rrainey/DSKY_EL_replica/PCB - KiCad/DSKY_driver_clr/Driver.Segment.PCB.BOM.xlsx

DRIVER BOARD
Verified | Designator | MFR P/N | Description | QTY | Mouser | Price | EXT | Digikey | Price | EXT
V | U1, U5, U7 | HV507PG-G | Serial to Parallel Logic Converters 325V 64Ch Push-Pull | 3 | 689-HV507PG-G | $14.34 | $43.02 | HV507PG-G-ND | $14.35 | $43.05
 | IC3 | ATSAMD21E18A-MUT | ARM Microcontrollers - MCU 256KB 32QFN GRN 1.6-3.6V 48MHz | 1 | 556-ATSAMD21E18A-MUT | $3.00 | $3.00 | ATSAMD21E18A-MUTCT-ND | $3.01 | $3.01
V | IC3 |  | ATSAMD21E18 Trinket M0 SAM D ARM® Cortex®-M0+ MCU 32-Bit Embedded Evaluation Board | 1 | 485-3500 | $8.95 | $8.95 | 1528-2361-ND | $8.95 | $8.95
V | TR1, TR2 | ATB322524-0110 | Audio Transformers / Signal Transformers Photoflash Capacitor Charging Transformer | 2 | 810-ATB322524-0110 | $1.78 | $3.56 | 445-8636-1-ND | $1.98 | $3.96
V | U2, U6 | LT3468ES5#TRMPBF | Switching Voltage Regulators 500mA Photoflash Capacitor Charger | 2 | 584-LT3468ES5#TRMPBF | $5.06 | $10.12 | LT3468ES5#TRMPBFCT-ND | $5.07 | $10.14
V | D1, D2 | B0540W-7-F | Schottky Diodes & Rectifiers 40V 410mW | 2 | 621-B0540W-F | $0.39 | $0.78 | B0540W-FDICT-ND | $0.30 | $0.60
V | D3, D4 | MMBD5004S-7 | Diodes - General Purpose, Power, Switching 350MW 400V | 2 | 621-MMBD5004S-7 | $0.43 | $0.86 | MMBD5004S-7DICT-ND | $0.43 | $0.86
V | U8 | CD40109BPWR | Translation - Voltage Levels Quad L-H Voltage | 1 | 595-CD40109BPWR | $0.42 | $0.42 | 296-12163-1-ND | $0.43 | $0.43
V | U4 | AP2204K-5.0TRG1 | LDO Voltage Regulators 150mA CMOS LDO 5.0V | 1 | 621-AP2204K-5.0TRG1 | $0.44 | $0.44 | AP2204K-5.0TRG1DICT-ND | $0.45 | $0.45
V | U3 | AP2204K-3.3TRG1 | LDO Voltage Regulators 200mA CMOS LDO 3.3V | 1 | 621-AP2204K-3.3TRG1 | $0.44 | $0.44 | AP2204K-3.3TRG1DICT-ND | $0.45 | $0.45
 | R1 | RC0603FR-071K5L | Thick Film Resistors - SMD 1.5K OHM 1% | 1 | 603-RC0603FR-071K5L | $0.10 | $0.10 | 311-1.50KHRCT-ND | $0.10 | $0.10
 | R4 | RC0603FR-0710KL | Thick Film Resistors - SMD 10K OHM 1% | 1 | 603-RC0603FR-0710KL | $0.10 | $0.10 | 311-10.0KHRCT-ND | $0.10 | $0.10
 | R3 | RC0603FR-07100KL | Thick Film Resistors - SMD 100K OHM 1% | 1 | 603-RC0603FR-07100KL | $0.10 | $0.10 | 311-100KHRCT-ND | $0.10 | $0.10
 | R2 | RC0603FR-0710ML | Thick Film Resistors - SMD 10M OHM 1% | 1 | 603-RC0603FR-0710ML | $0.10 | $0.10 | 311-10.0MHRCT-ND | $0.10 | $0.10
V | C5, C9 | C1608X5R1C685K080AB | Multilayer Ceramic Capacitors MLCC - SMD/SMT 0603 16V 6.8uF X5R 10% T: 0.8mm | 2 | 810-C1608JB1A685K08C | $0.62 | $1.24 | 445-14139-1-ND | $0.72 | $1.44
V | C15, C16, C17 | C3225X7T2W224K200AA | Multilayer Ceramic Capacitors MLCC - SMD/SMT 1210 450V 0.22uF X7T 10% T: 2mm | 3 | 810-C1608X5R1C685K0B | $0.95 | $2.85 | 445-7765-1-ND | $0.73 | $2.19
V | C4 | C5750X6S2W225K250KA | Multilayer Ceramic Capacitors MLCC - SMD/SMT 2220 450V 2.2uF X6S 10% T: 2.5mm | 1 | 810-C5750X6S2W225KKA | $0.32 | $0.32 | 445-7781-1-ND | $3.99 | $3.99
 | C10 | C0603C103K9RACTU | Multilayer Ceramic Capacitors MLCC - SMD/SMT 6.3V 0.01uF 0603 X7R 10% | 1 | 80-C0603C103K9R | $0.11 | $0.11 | 399-8988-1-ND | $0.11 | $0.11
 | C14,C13,C12,C11,C2,C3 | C0603C105K8RACTU | Multilayer Ceramic Capacitors MLCC - SMD/SMT 10volts 1uF 10% X7R | 6 | 80-C0603C105K8R | $0.10 | $0.60 | 399-11133-1-ND | $0.10 | $0.60
 | C1,C7,C8 | 0805ZC106KAT4A | Multilayer Ceramic Capacitors MLCC - SMD/SMT 10V 10uF X7R 0805 0.1 | 3 | 581-0805ZC106KAT4A | $0.87 | $2.61 | 478-10578-1-ND | $0.80 | $2.40
 | C6 | 885012006008 | Multilayer Ceramic Capacitors MLCC - SMD/SMT 6.3V 100pF X7R 0603 5% | 1 | 710-885012006008 | $0.10 | $0.10 | 732-7752-1-ND | $0.10 | $0.10
 | Q2 | 1301.9317 | Tactile Switches SHORT TRAVEL SWITCH 6X6, 7.3MM | 1 | 693-1301.9317 | $0.24 | $0.24 | 486-3468-ND | $0.24 | $0.24
V | X1 | 105133-0011 | USB Connectors USB B Rec Vertical SMT 2.30 | 1 | 538-105133-0011 | $0.94 | $0.94 | WM10134CT-ND | $1.11 | $1.11
 | L1 | 150060RS75000 | Standard LEDs - SMD WL-SMCW SMDMono TpVw Waterclr 0603 Red | 1 | 710-150060RS75000 | $0.14 | $0.14 | 732-4978-1-ND | $0.14 | $0.14
 | PWR1 | 150060VS75000 | Standard LEDs - SMD WL-SMCW SMDMono TpVw Waterclr 0603 BrtGrn | 1 | 710-150060VS75000 | $0.14 | $0.14 | 732-4980-1-ND | $0.14 | $0.14
V | J3 | PJ-006B-SMT-TR | DC Power Connectors power jack, 2.5 x 5.5 mm, vertical, SMT, 1 switch, T&R package | 1 | 490-PJ-006B-SMT-TR | $1.04 | $1.04 | CP-006BPJCT-ND | $1.14 | $1.14
V | J1, J2, J4 | FX6-60S-0.8SV(71) | Board to Board & Mezzanine Connectors RCP 60 POS 0.8mm Solder ST SMD Stick | 3 | 798-FX6-60S-0.8SV71 | $3.53 | $10.59 | H10806-ND | $3.53 | $10.59
V | P1 | WSU090-2000-13 | 100-240V WALL PLUG-IN PWR SUPPLY | 1 | 553-WSU090-2000-13 | $11.45 | $11.45 | 237-2263-ND | $12.39 | $12.39
ARM Chip Only |  |  |  |  |  |  | #ERROR! |  |  | #ERROR!
ARM Chip on Development Board |  |  |  |  |  |  | #ERROR! |  |  | #ERROR!
SEGMENT BOARD
V | J1, J2, J3 | FX6-60P-0.8SV(71) | Board to Board & Mezzanine Connectors HDR 60 POS 0.8mm Solder ST SMD Stick | 3 | 798-FX6-60P-0.8SV71 | $3.68 | $11.04 | H10787-ND | $3.68 | $11.04
V | D1 | MMBD5004S-7 | Diodes - General Purpose, Power, Switching 350MW 400V | 1 | 621-MMBD5004S-7 | $0.43 | $0.43 | MMBD5004S-7DICT-ND | $0.43 | $0.43
 |  |  |  |  |  |  | $11.47 |  |  | $11.47
 | Requires desoldering to obtain the chip
 | No equivalent
