rrainey/DSKY_EL_replica/PCB - KiCad/DSKY_driver_clr/DSKY_driver.kicad_pcb

## KiCad design PCB - KiCad/DSKY_driver_clr/DSKY_driver.kicad_pcb (2021-01-31)

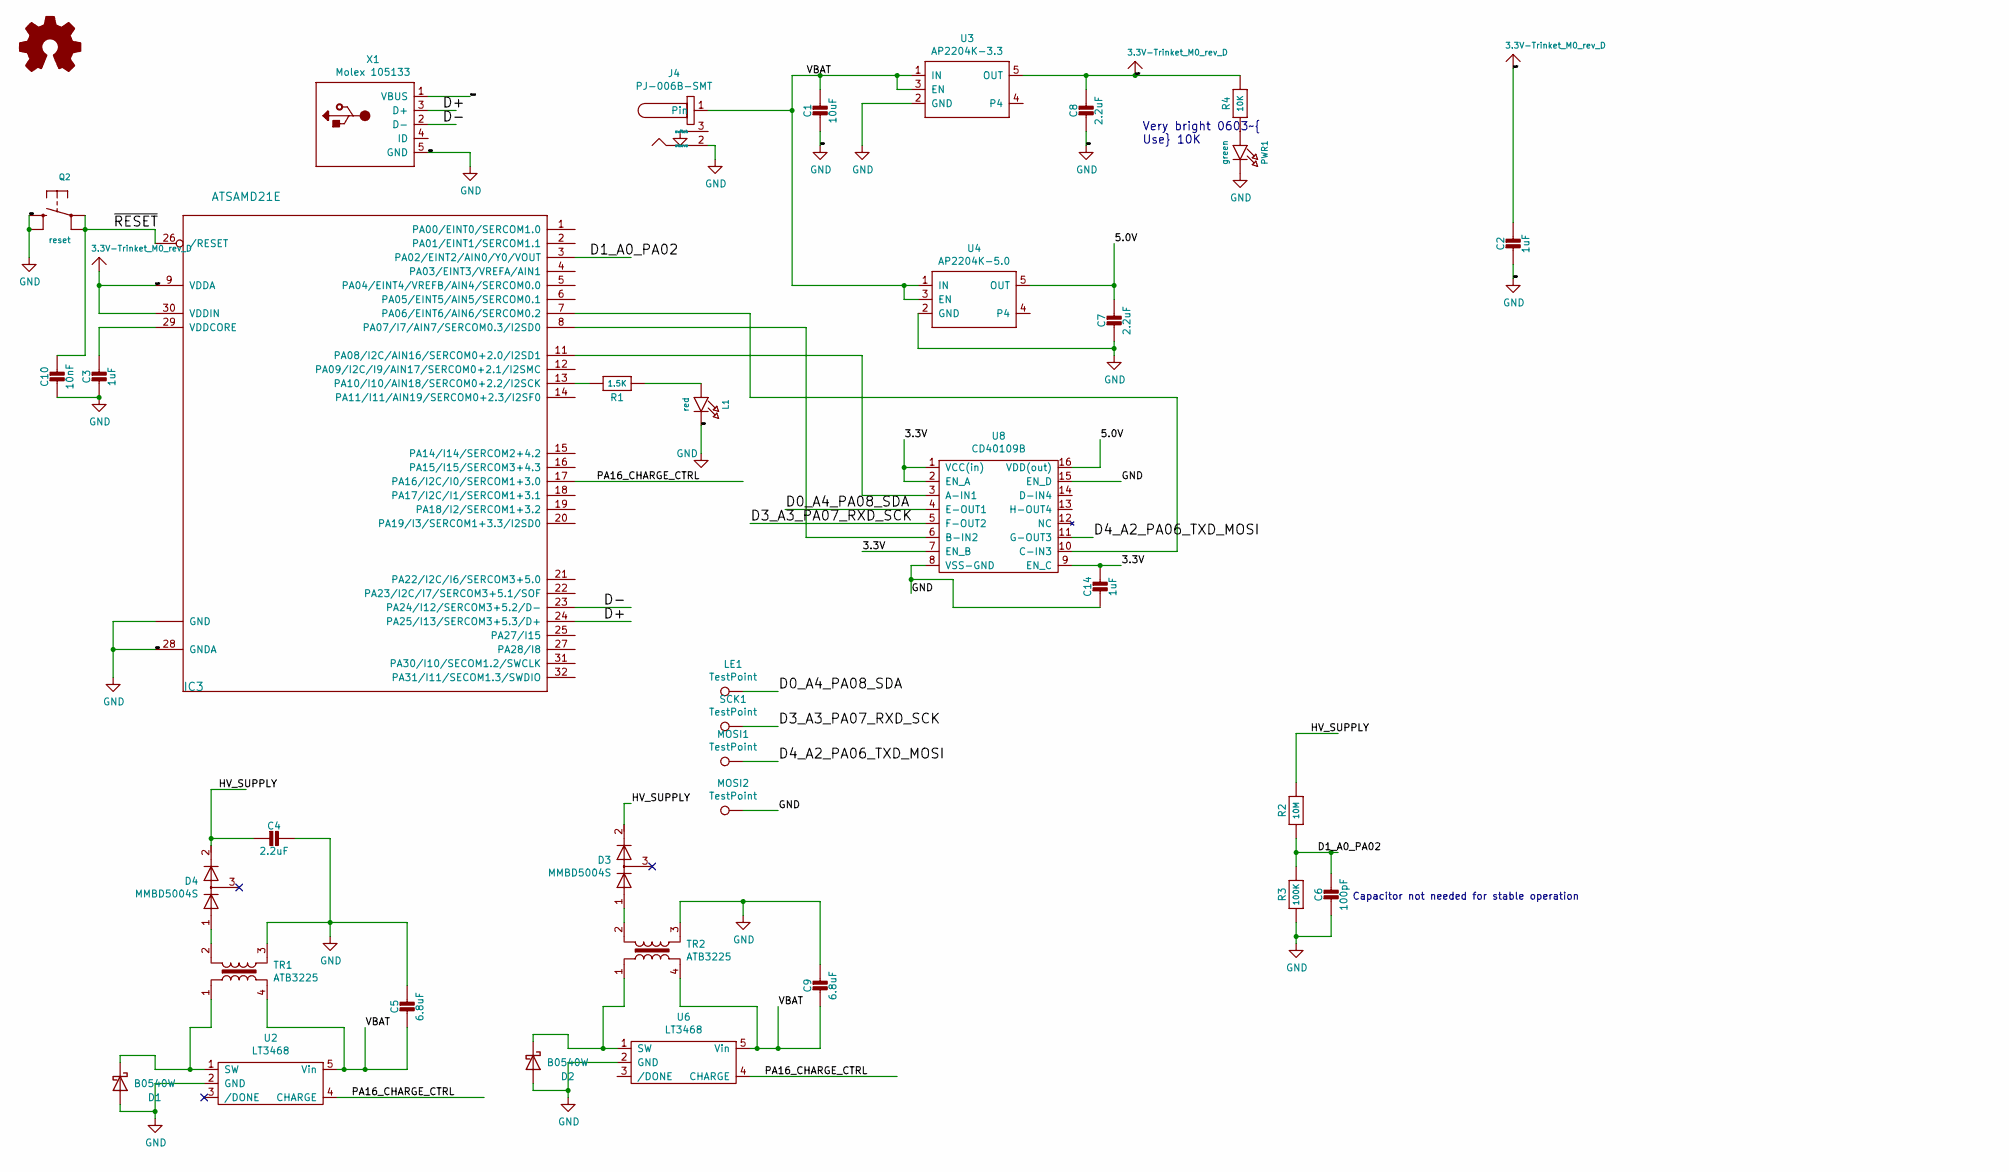
[picture p1: schematic DSKY_driver.sch, part in row 1, column 1]

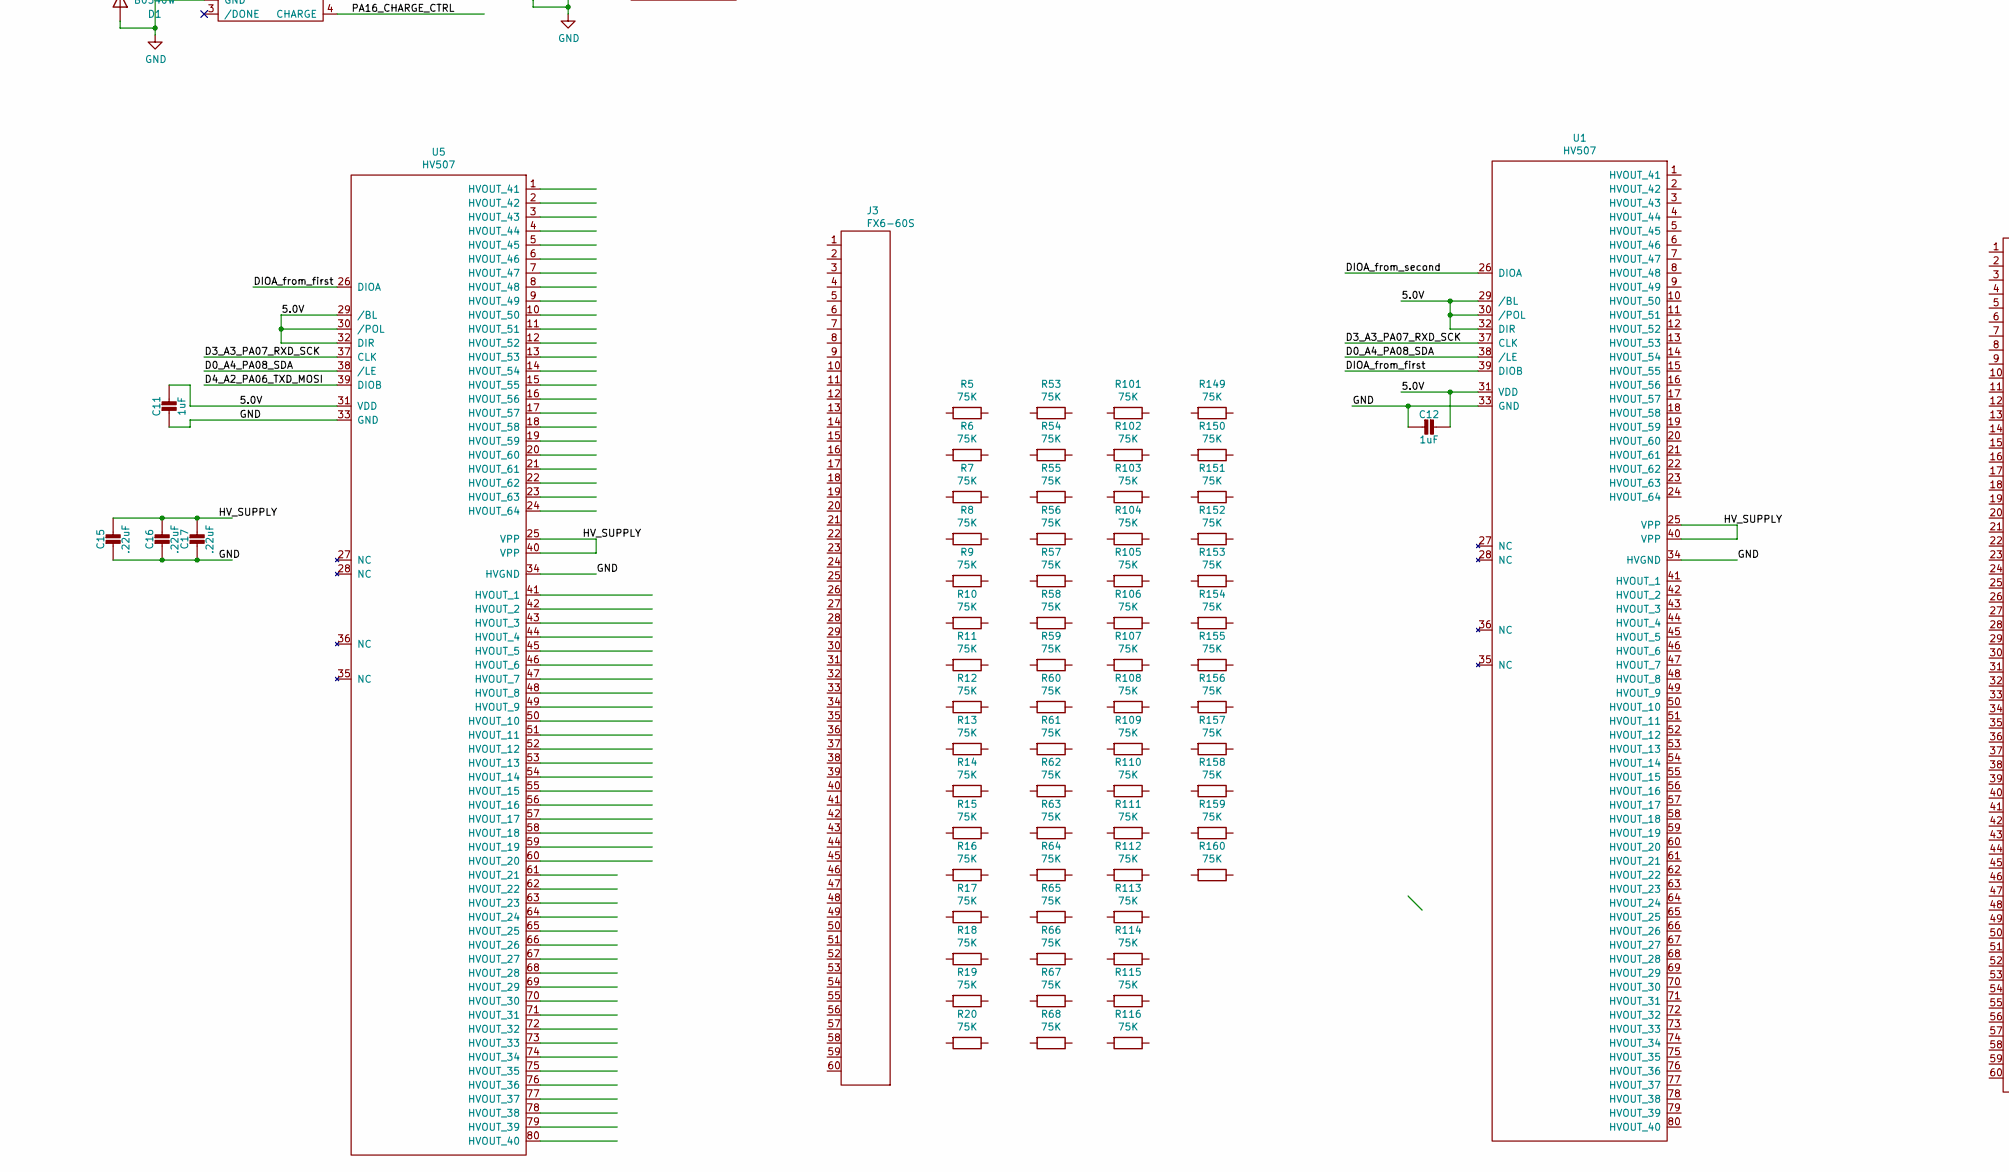
[picture p2: schematic DSKY_driver.sch, part in row 2, column 1]

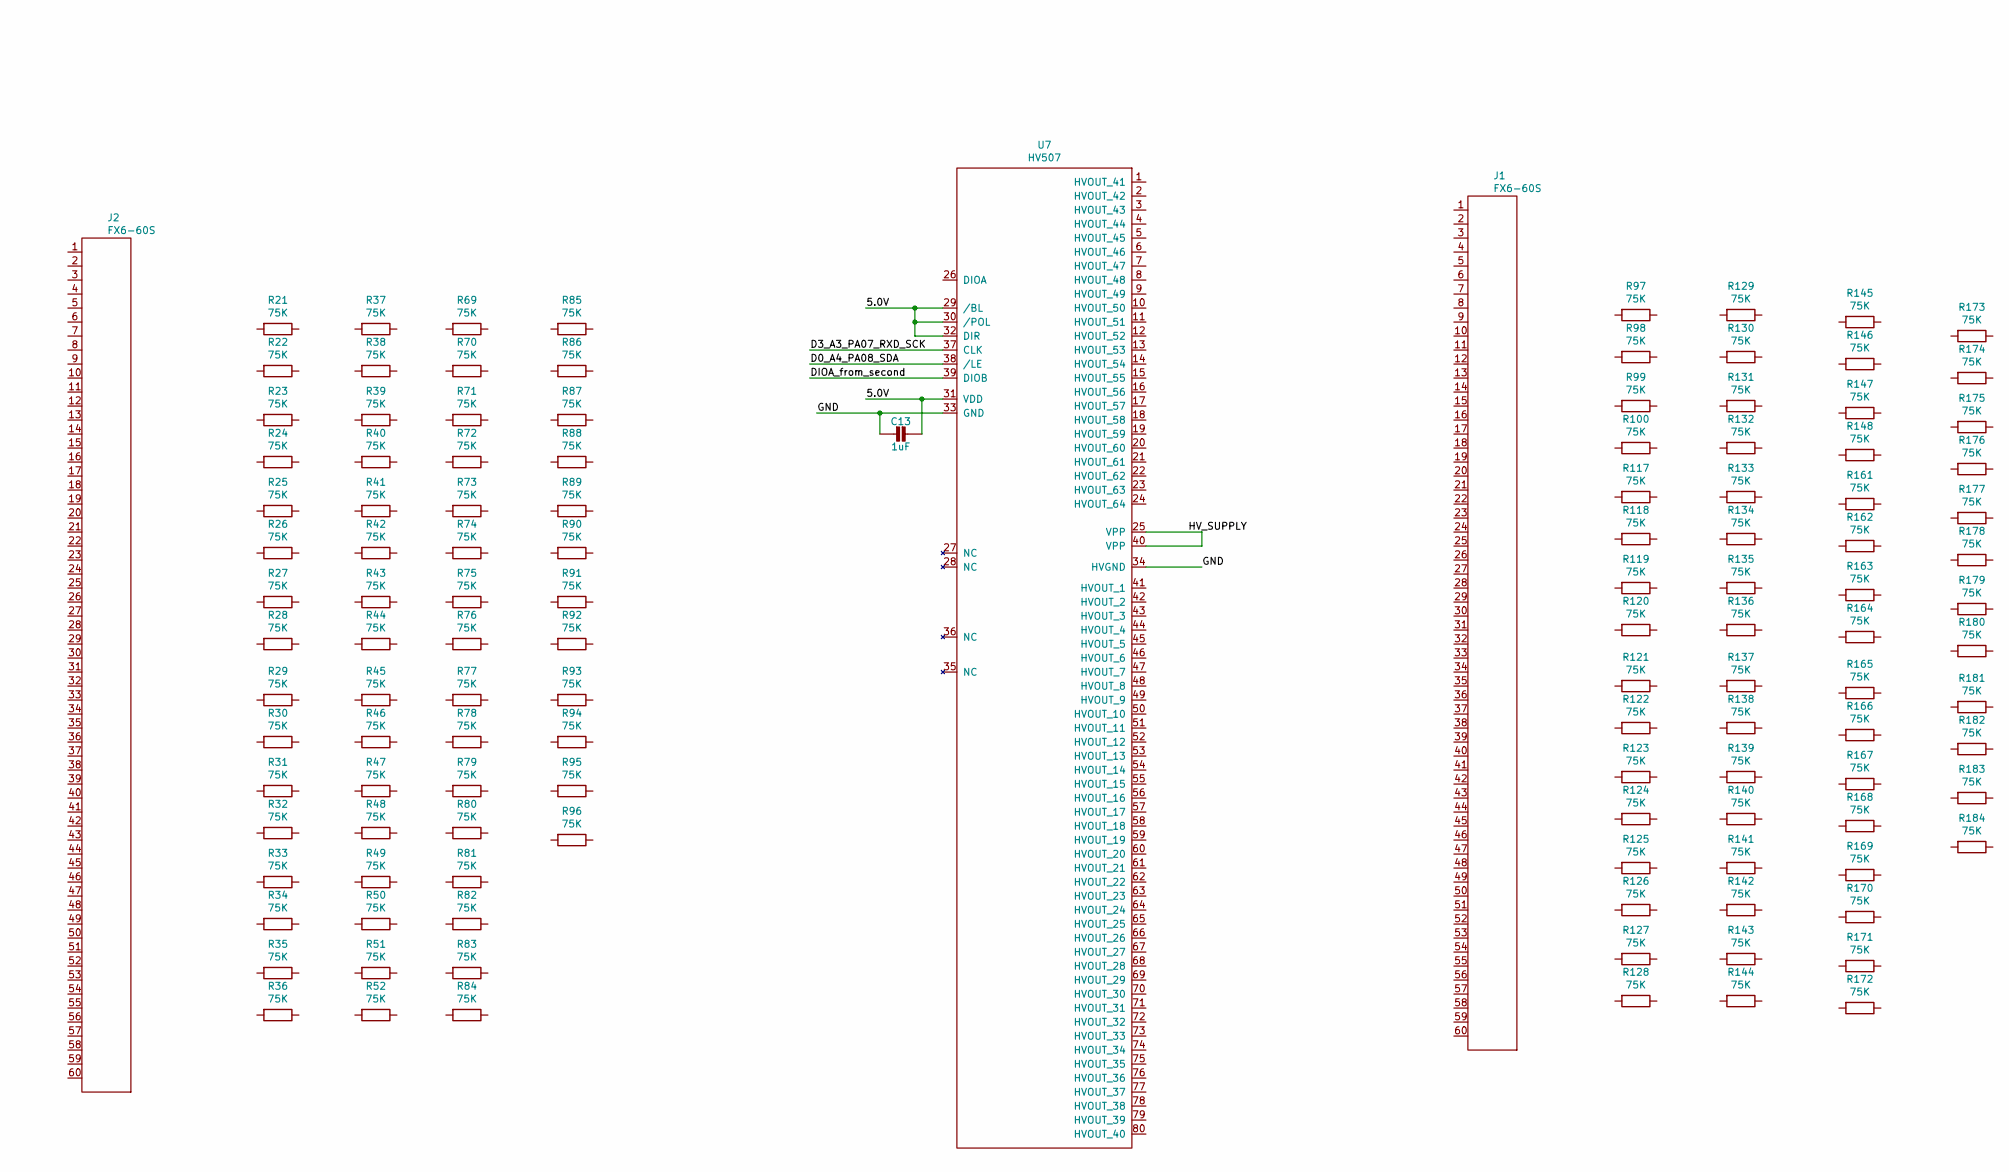
[picture p3: schematic DSKY_driver.sch, part in row 2, column 2]

Parts:
C1: 10uF; 0805-NO
C2, C3, C11, C12, C13, C14: 1uF; 0603-NO
C4: 2.2uF; C_2220_5650Metric
C5, C9: 6.8uF; 0603-NO
C6: 100pF; 0603-NO
C7, C8: 2.2uF; 0805-NO
C10: 10nF; 0603-NO
C15, C16, C17: .22uF; C_1210_3225Metric
D1, D2: B0540W; D_SOD-123
D3, D4: MMBD5004S; SOT-23
IC3: ATSAMD21E; QFN32_5MM
J1, J2, J3: FX6-60S
J4: PJ-006B-SMT; CUI_PJ-006B-SMT_power_jack
L1: red; CHIPLED_0603_NOOUTLINE
LE1: TestPoint; TestPoint_Pad_D1.0mm
LOGO1: Logo_Open_Hardware_Small; OSHW-Logo_5.7x6mm_SilkScreen
MOSI1, MOSI2: TestPoint; TestPoint_Pad_D1.0mm
PWR1: green; CHIPLED_0603_NOOUTLINE
Q2: reset; BTN_KMR2_4.6X2.8
R1: 1.5K; 0603-NO
R2: 10M; 0603-NO
R3: 100K; 0603-NO
R4: 10K; 0603-NO
R5, R6, R7, R8, R9, R10, R11, R12, R13, R14, R15, R16, R17, R18, R19, R20, R21, R22, R23, R24, R25, R26, R27, R28, R29, R30, R31, R32, R33, R34, R35, R36, R37, R38, R39, R40, R41, R42, R43, R44, R45, R46, R47, R48, R49, R50, R51, R52, R53, R54, R55, R56, R57, R58, R59, R60, R61, R62, R63, R64, R65, R66, R67, R68, R69, R70, R71, R72, R73, R74, R75, R76, R77, R78, R79, R80, R81, R82, R83, R84, R85, R86, R87, R88, R89, R90, R91, R92, R93, R94, R95, R96, R97, R98, R99, R100, R101, R102, R103, R104, R105, R106, R107, R108, R109, R110, R111, R112, R113, R114, R115, R116, R117, R118, R119, R120, R121, R122, R123, R124, R125, R126, R127, R128, R129, R130, R131, R132, R133, R134, R135, R136, R137, R138, R139, R140, R141, R142, R143, R144, R145, R146, R147, R148, R149, R150, R151, R152, R153, R154, R155, R156, R157, R158, R159, R160, R161, R162, R163, R164, R165, R166, R167, R168, R169, R170, R171, R172, R173, R174, R175, R176, R177, R178, R179, R180, R181, R182, R183, R184: 75K; R_0201_0603Metric
SCK1: TestPoint; TestPoint_Pad_D1.0mm
TR1, TR2: ATB3225
U1, U5, U7: HV507; QFP-96_14x20_Pitch0.8mm
U2, U6: LT3468; SOT-23-5
U3: AP2204K-3.3; SOT-23-5
U4: AP2204K-5.0; SOT-23-5
U8: CD40109B; TSSOP-16_4.4x5mm_P0.65mm
X1: Molex 105133; molex_105133_vertical_USB

Connections:
3.3V: C2.1, C8.1, C14.1, IC3.9 (VDDA), IC3.30 (VDDIN), R4.2, U3.5 (OUT), U8.1 (VCC(in)), U8.2 (EN_A), U8.7 (EN_B), U8.9 (EN_C)
/5.0V: C7.1, C11.1, C12.1, C13.1, U1.29 (/BL), U1.30 (/POL), U1.31 (VDD), U1.32 (DIR), U4.5 (OUT), U5.29 (/BL), U5.30 (/POL), U5.31 (VDD), U5.32 (DIR), U7.29 (/BL), U7.30 (/POL), U7.31 (VDD), U7.32 (DIR), U8.16 (VDD(out))
/D0_A4_PA08_SDA: LE1.1, U1.38 (/LE), U5.38 (/LE), U7.38 (/LE), U8.4 (E-OUT1)
/D1_A0_PA02: C6.1, IC3.3 (PA02/EINT2/AIN0/Y0/VOUT), R2.1, R3.2
/D3_A3_PA07_RXD_SCK: SCK1.1, U1.37 (CLK), U5.37 (CLK), U7.37 (CLK), U8.5 (F-OUT2)
/D4_A2_PA06_TXD_MOSI: MOSI1.1, U5.39 (DIOB), U8.11 (G-OUT3)
/D+: IC3.24 (PA25/I13/SERCOM3+5.3/D+), X1.3 (D+)
/D-: IC3.23 (PA24/I12/SERCOM3+5.2/D-), X1.2 (D-)
/DIOA_from_first: U1.39 (DIOB), U5.26 (DIOA)
/DIOA_from_second: U1.26 (DIOA), U7.39 (DIOB)
/HV_SUPPLY: C4.2, C15.1, C16.1, C17.1, D3.2, D4.2, R2.2, U1.25 (VPP), U1.40 (VPP), U5.25 (VPP), U5.40 (VPP), U7.25 (VPP), U7.40 (VPP)
/PA16_CHARGE_CTRL: IC3.17 (PA16/I2C/I0/SERCOM1+3.0), U2.4 (CHARGE), U6.4 (CHARGE)
/VBAT: C1.1, C5.2, C9.2, J4.1, TR1.4, TR2.4, U2.5 (Vin), U3.1 (IN), U3.3 (EN), U4.1 (IN), U4.3 (EN), U6.5 (Vin)
/VBUS: X1.1 (VBUS)
/~RESET: C10.1, IC3.26 (/RESET), Q2.A, Q2.A' (P1)
GND: C1.2, C2.2, C3.2, C4.1, C5.1, C6.2, C7.2, C8.2, C9.1, C10.2, C11.2, C12.2, C13.2, C14.2, C15.2, C16.2, C17.2, D1.2 (A), D2.2 (A), IC3.10 (GND), IC3.28 (GNDA), IC3.33 (GND), J4.2 (sleeve), L1.C, MOSI2.1, PWR1.C, Q2.B (S), Q2.B' (S1), R3.1, TR1.3, TR2.3, U1.33 (GND), U1.34 (HVGND), U2.2 (GND), U3.2 (GND), U4.2 (GND), U5.33 (GND), U5.34 (HVGND), U6.2 (GND), U7.33 (GND), U7.34 (HVGND), U8.8 (VSS-GND), U8.15 (EN_D), X1.5 (GND), X1.6 (GND), X1.7 (GND), X1.8 (GND)
unnamed: C3.1, IC3.29 (VDDCORE)
unnamed: D1.1 (K), TR1.1, U2.1 (SW)
unnamed: D2.1 (K), TR2.1, U6.1 (SW)
unnamed: D3.1, TR2.2
unnamed: D4.1, TR1.2
unnamed: IC3.7 (PA06/EINT6/AIN6/SERCOM0.2), U8.10 (C-IN3)
unnamed: IC3.8 (PA07/I7/AIN7/SERCOM0.3/I2SD0), U8.6 (B-IN2)
unnamed: IC3.11 (PA08/I2C/AIN16/SERCOM0+2.0/I2SD1), U8.3 (A-IN1)
unnamed: IC3.13 (PA10/I10/AIN18/SERCOM0+2.2/I2SCK), R1.2
unnamed: L1.A, R1.1
unnamed: PWR1.A, R4.1

Notes on the sheet:
Very bright 0603~ Use 10K
Capacitor not needed for stable operation

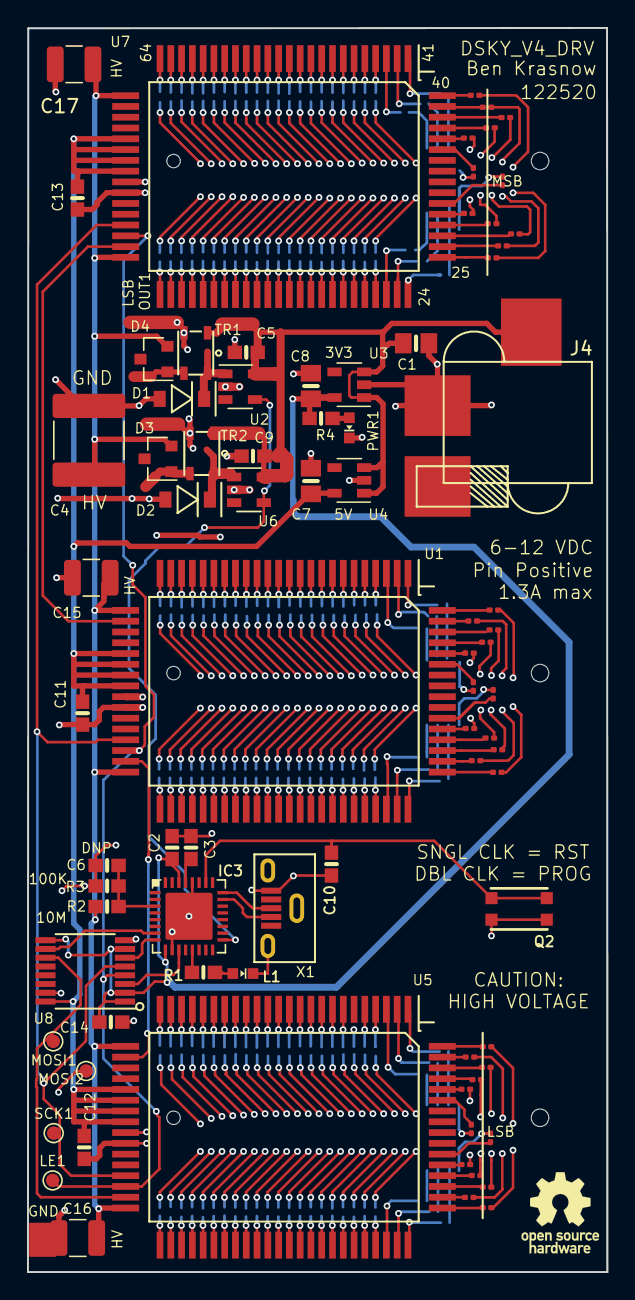
[picture p4: board DSKY_driver.kicad_pcb from above]

Board: 2 copper layers, 43.0 x 92.3 mm, 229 parts (0 on the bottom side), 26 nets.
