rrainey/DSKY_EL_replica/(commit log)

2020-12-20 Added draft "clr" - Current Limiting Resistor version of Driver board
    [DSKY_driver.kicad_pcb, DSKY_driver.sch, Driver.Segment.PCB.BOM.xlsx]
2020-12-23 Fine tuning resistor placement
    [DSKY_driver.kicad_pcb, DSKY_driver.sch]
2020-12-24 more reorganization of resistor layout
    [DSKY_driver.kicad_pcb]
2021-01-31 Latest draft PCB update
    [DSKY_driver.kicad_pcb]
